dl0muc/avs_operation_center/avs-mod-shield/documentation/schematic.pdf

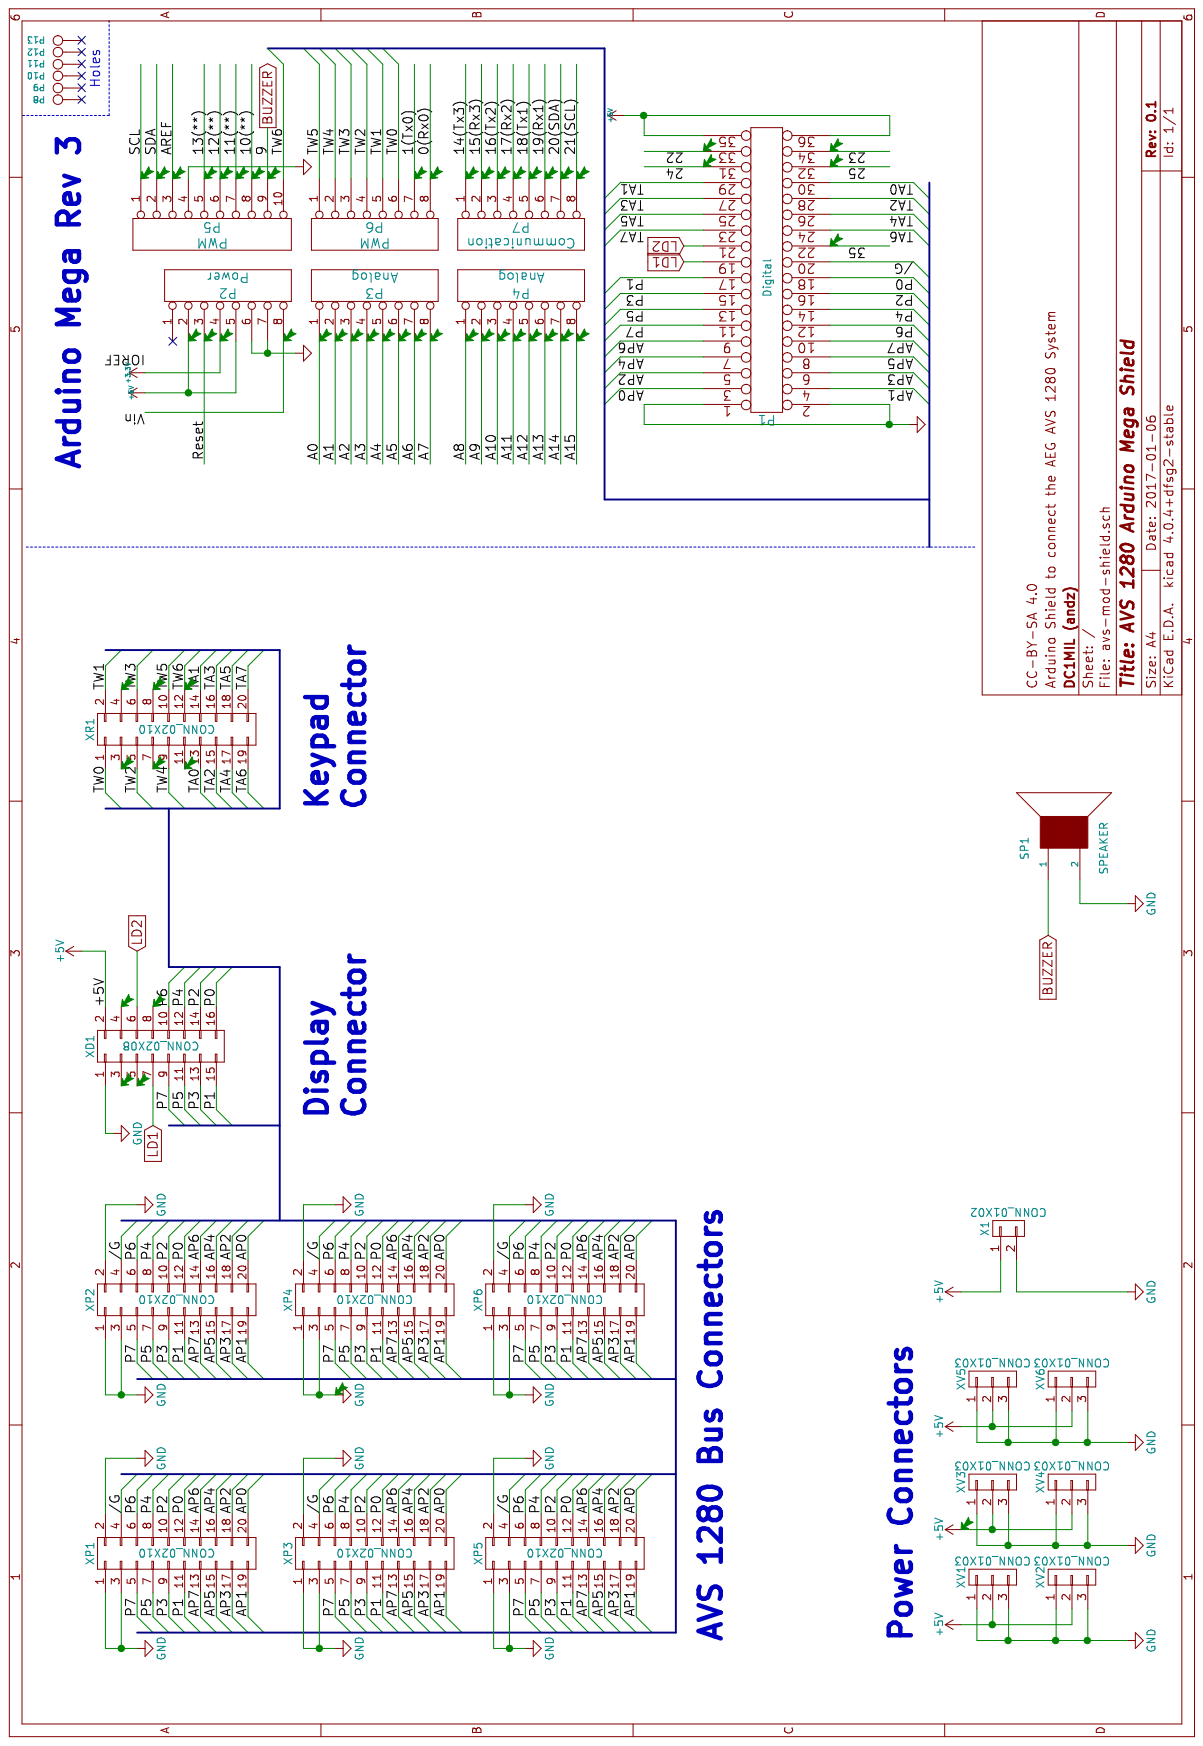
[picture p1: page 1]
