dl0muc/avs_operation_center/avs-mod-shield/documentation/layout.pdf

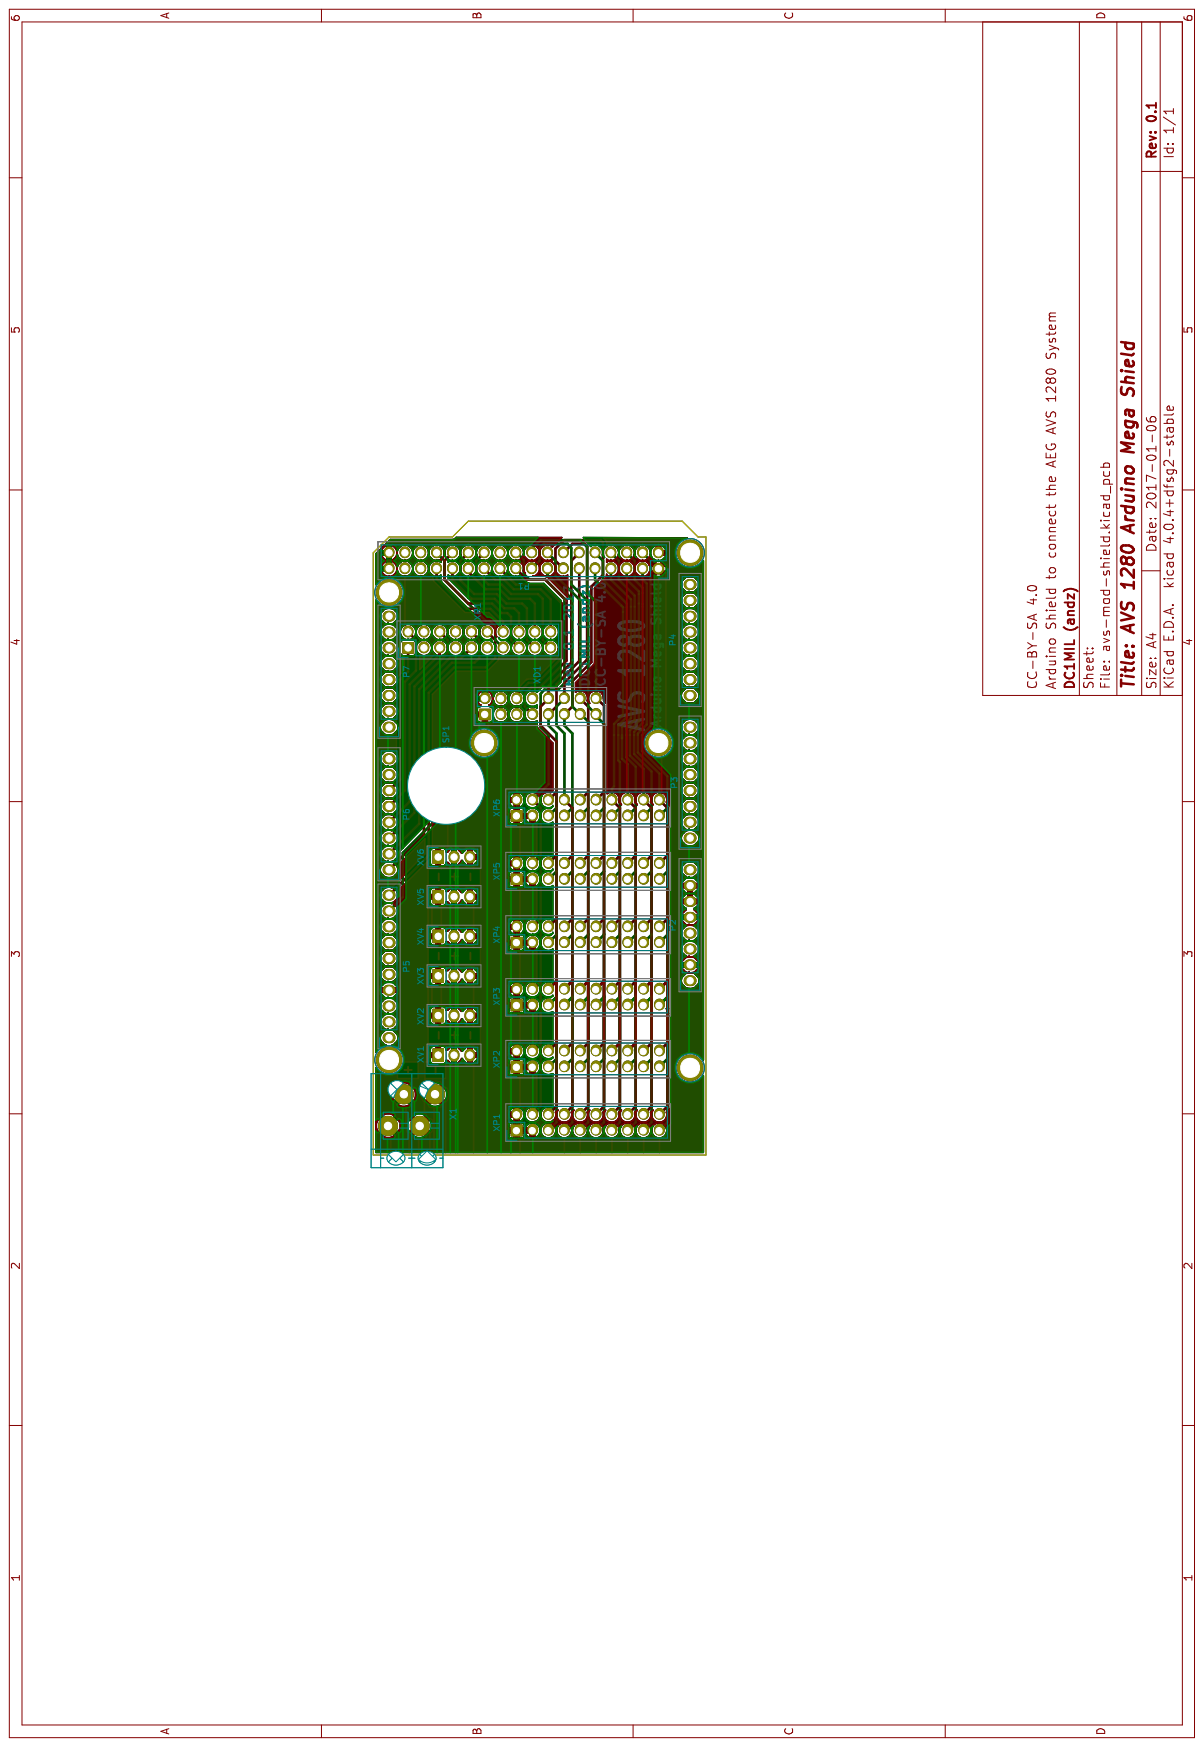
[picture p2: page 1]
