dl0muc/avs_operation_center/avs-mod-shield/hardware/avs-mod-shield.kicad_pcb

## KiCad design avs-mod-shield/hardware/avs-mod-shield.kicad_pcb (2017-01-06)

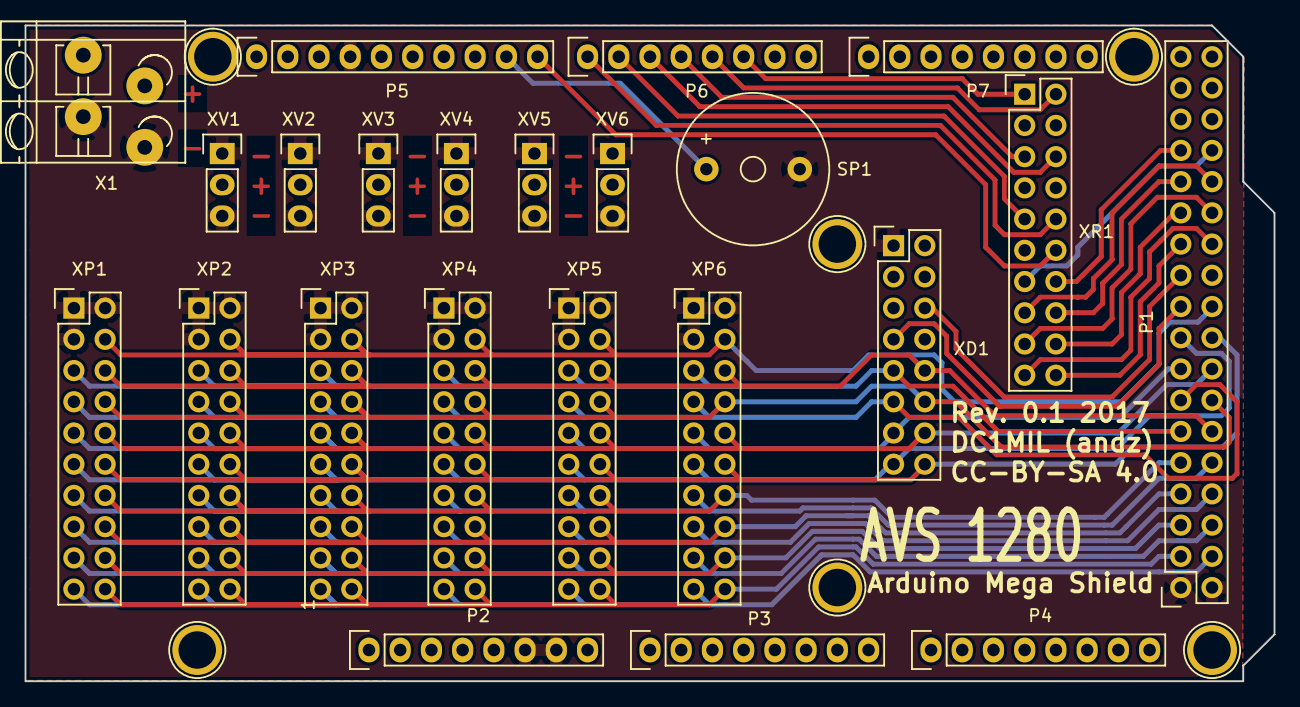
[picture p3: board avs-mod-shield.kicad_pcb from above]

Board: 2 copper layers, 101.6 x 53.3 mm, 29 parts (0 on the bottom side), 37 nets.

Parts:
P1: Digital; Socket_Strip_Arduino_2x18
P2: Power; Socket_Strip_Arduino_1x08
P3, P4: Analog; Socket_Strip_Arduino_1x08
P5: PWM; Socket_Strip_Arduino_1x10
P6: PWM; Socket_Strip_Arduino_1x08
P7: Communication; Socket_Strip_Arduino_1x08
P8, P9, P10, P11, P12, P13: CONN_1; Arduino_1pin
SP1: SPEAKER; Buzzer_12x9.5RM7.6
X1: CONN_01X02; TerminalBlock_WAGO-804_RM5mm_2pol
XD1: CONN_02X08; Pin_Header_Straight_2x08
XP1, XP2, XP3, XP4, XP5, XP6: CONN_02X10; Pin_Header_Straight_2x10
XR1: CONN_02X10; Pin_Header_Straight_2x10
XV1, XV2, XV3, XV4, XV5, XV6: CONN_01X03; Pin_Header_Straight_1x03

Connections:
+5V: P1.35, P1.36, P2.2, P2.5, X1.1, XD1.2, XV1.2, XV2.2, XV3.2, XV4.2, XV5.2, XV6.2
//G: P1.20, XP1.4, XP2.4, XP3.4, XP4.4, XP5.4, XP6.4
/AP0: P1.3, XP1.20, XP2.20, XP3.20, XP4.20, XP5.20, XP6.20
/AP1: P1.4, XP1.19, XP2.19, XP3.19, XP4.19, XP5.19, XP6.19
/AP2: P1.5, XP1.18, XP2.18, XP3.18, XP4.18, XP5.18, XP6.18
/AP3: P1.6, XP1.17, XP2.17, XP3.17, XP4.17, XP5.17, XP6.17
/AP4: P1.7, XP1.16, XP2.16, XP3.16, XP4.16, XP5.16, XP6.16
/AP5: P1.8, XP1.15, XP2.15, XP3.15, XP4.15, XP5.15, XP6.15
/AP6: P1.9, XP1.14, XP2.14, XP3.14, XP4.14, XP5.14, XP6.14
/AP7: P1.10, XP1.13, XP2.13, XP3.13, XP4.13, XP5.13, XP6.13
/P0: P1.18, XD1.16, XP1.12, XP2.12, XP3.12, XP4.12, XP5.12, XP6.12
/P1: P1.17, XD1.15, XP1.11, XP2.11, XP3.11, XP4.11, XP5.11, XP6.11
/P2: P1.16, XD1.14, XP1.10, XP2.10, XP3.10, XP4.10, XP5.10, XP6.10
/P3: P1.15, XD1.13, XP1.9, XP2.9, XP3.9, XP4.9, XP5.9, XP6.9
/P4: P1.14, XD1.12, XP1.8, XP2.8, XP3.8, XP4.8, XP5.8, XP6.8
/P5: P1.13, XD1.11, XP1.7, XP2.7, XP3.7, XP4.7, XP5.7, XP6.7
/P6: P1.12, XD1.10, XP1.6, XP2.6, XP3.6, XP4.6, XP5.6, XP6.6
/P7: P1.11, XD1.9, XP1.5, XP2.5, XP3.5, XP4.5, XP5.5, XP6.5
/TA0: P1.30, XR1.13
/TA1: P1.29, XR1.14
/TA2: P1.28, XR1.15
/TA3: P1.27, XR1.16
/TA4: P1.26, XR1.17
/TA5: P1.25, XR1.18
/TA6: P1.24, XR1.19
/TA7: P1.23, XR1.20
/TW0: P6.6, XR1.1
/TW1: P6.5, XR1.2
/TW2: P6.4, XR1.5
/TW3: P6.3, XR1.6
/TW4: P6.2, XR1.9
/TW5: P6.1, XR1.10
/TW6: P5.10, XR1.12
BUZZER: P5.9, SP1.1
GND: P1.1, P1.2, P2.6, P2.7, P5.4, SP1.2, X1.2, XD1.1, XP1.1, XP1.2, XP1.3, XP2.1, XP2.2, XP2.3, XP3.1, XP3.2, XP3.3, XP4.1, XP4.2, XP4.3, XP5.1, XP5.2, XP5.3, XP6.1, XP6.2, XP6.3, XV1.1, XV1.3, XV2.1, XV2.3, XV3.1, XV3.3, XV4.1, XV4.3, XV5.1, XV5.3, XV6.1, XV6.3
LD1: P1.19, XD1.7
LD2: P1.21, XD1.6
