dl0muc/avs_operation_center/avs-mod-shield/firmware/avs.cpp

/// 
/// @file
///
/// @brief     AVS functions
///
/// @author    DC1MIL - andz
/// @date      2017-01-07
/// @copyright CC-BY-SA 4.0
///
/// @details   This file is part of the AVS Arduino Shield Firmware
///

#include "avs.h"
#include "Arduino.h"

///
///
///

Avs::Avs() {
    m_avs_bus = new AvsBusCommunication();
    m_avs_display = new AvsDisplay(m_avs_bus);
}

void Avs::commandLoop() {
// Do all the commands here
    m_avs_display->writeString("    Hello World!    ", 20, AvsDisplay::LD1, false);
    m_avs_display->writeString("       DL0MUC       ", 20, AvsDisplay::LD2, false);
    delay(2000);
    m_avs_display->writeString("    Hello World!    ", 20, AvsDisplay::LD1, false);
    m_avs_display->writeString("       DL0MUC       ", 20, AvsDisplay::LD2, true);
    delay(2000);
}
