dl0muc/avs_operation_center/(commit log)

2017-01-06 NOTICKET: Finalized Shield to Revision 0.1
    - Finalized Schematic
    - Finalized Layout
    - Created Gerber Files
    - Created pdf
    [avs-mod-shield.kicad_pcb, avs-mod-shield.sch]
2017-01-07 NOTICKET: Initial commit of firmware
    - Created initial frame for the firmware
    - Added some documentaion
    [configuration.h]
2017-01-11 NOTICKET: Added Display Controller Datasheet
    [configuration.h]
2017-01-12 NOTICKET: Fixed minor bug in avs_display.cpp
    [avs_display.cpp]
2017-01-30 NOTICKET: Changed some timings after first usage with real hardware
    - Still needs some refactoring
    - doesn't initialize sometimes
    - sometimes initializes only with one line
    [avs.cpp, avs_bus_communication.cpp, avs_bus_communication.h, avs_display.cpp, avs_display.h]
